Idetic/OCC_boards/README.md

# OCC_boards
Repository to share of OCC related PCB.
