Idetic/OCC_boards/Constant_Current_PCB/last_version/README.md

# STM32 Constant-Current LED Driver Board

A compact STM32-controlled LED driver with an adjustable linear current sink, high-side current sensing, USB-C, and expansion headers. The circuit can drive an external LED from a 5 V supply, with the current reference provided by the MCU's PA4 DAC output.

This document describes the checked-in KiCad schematic and PCB. Values are design values, not measured performance guarantees. Output current limits, modulation bandwidth, and thermal performance still require characterization.

## Board specifications

| Parameter | Design specification |
| --- | --- |
| Project | `hat_rpizero_tx` |
| CAD version | PCB saved with KiCad 9.0 |
| PCB outline | 39.67 × 22.70 mm, rectangular, measured from Edge.Cuts |
| Configured PCB thickness | 1.6062 mm |
| Copper layers | Four: F.Cu, In1.Cu, In2.Cu, B.Cu |
| Dielectric | FR4 in the configured stackup |
| Configured copper thickness | Outer layers: 35 µm; inner layers: 15.2 µm |
| Supply rail | Nominal +5 V from USB-C or POWER2 |
| Logic rail | +3.3 V, generated by U4 (TLV75533PDBVR) |
| Microcontroller | U1: STM32L432KCU6, UFQFPN-32 with exposed pad |
| External crystal | X1: 32.768 kHz, specified component load capacitance 6 pF and tolerance 20 ppm |
| Crystal capacitors | C1, C2: 8 pF each |
| LED outputs | One external LED connection, LED1 |
| Current control | U2 MCP6001T-I/OT, Q1 2N2222AU, R5 and R7 trimmers |
| Current measurement | U3 INA199A1DCKR with R8 = 0.110 Ω high-side shunt |
| Interfaces | USB data, SWD, serial signal header, I²C, PA1–PA3, two DAC signals |
| Firmware | No firmware or flashing image included in this directory |

The project filename does not establish Raspberry Pi HAT compatibility. The current PCB has no 40-pin Raspberry Pi header.

## Power

USB1 VBUS and POWER2 pin 1 connect directly to the same +5 V net. U4 generates +3.3 V for the MCU and logic headers; U2 and U3 use +5 V. USB-C CC1 and CC2 each have a 5.1 kΩ pull-down resistor (R9 and R10).

The design has no separate power-source selection or isolation between USB VBUS and POWER2. Use one supply source at a time unless the external power arrangement explicitly handles the shared rail. The files do not establish an approved input-voltage range or total current budget.

## LED current driver

The LED current path is:

```text
+5 V → R8 (0.110 Ω) → LED1 pin 1 → external LED
     → LED1 pin 2 → Q1 collector/emitter → R7 → GND
```

U2 compares the R5 wiper voltage with Q1's emitter voltage and drives Q1's base. R5 is a 10 kΩ trimmer between DAC1/PA4 and ground. R7 is a 100 Ω trimmer used as a variable emitter resistor; its third terminal is unconnected. R6 is a 10 kΩ resistor between Q1 base and emitter.

While the feedback loop is regulating, the approximate relationships are:

```text
V_reference = α × V_DAC1                  (0 ≤ α ≤ 1, set by R5)
I_emitter ≈ V_reference / R7_effective
I_LED ≈ I_emitter                        (neglecting base current and R6 current)
V_shunt = I_LED × 0.110 Ω
V_I_LED ≈ G_INA199A1 × V_shunt            (within the amplifier's operating limits)
```

These equations describe circuit operation, not a safe current range. R7 can approach zero resistance, so its marked 100 Ω value does not provide a fixed minimum current-limiting resistance. The usable current depends on trimmer settings, DAC voltage, LED forward voltage, transistor dissipation, component ratings, and available voltage headroom. The board does not include a switching boost stage.

U3 measures the voltage across R8. Its output is available at SW2 pin 4 (`I_LED`); the netlist does not connect this output directly to an MCU ADC input. Check the amplifier output range before connecting it to a 3.3 V input.

## Connector pinouts

Pin numbers below follow the schematic symbols and PCB pad numbers. Use the footprint's pin-1 marker to determine physical orientation.

| Connector | Pin | Signal | Description |
| --- | --- | --- | --- |
| POWER2 | 1 | +5V | Supply input, shared with USB VBUS |
| POWER2 | 2 | GND | Supply return |
| LED1 | 1 | LED+ | LED anode supply, after R8 |
| LED1 | 2 | LED− / Collector | LED cathode connection to Q1 collector; not ground |
| DAC1 | 1 | DAC1 | MCU PA4; also feeds R5 |
| DAC1 | 2 | DAC2 | MCU PA5; this connector has no ground pin |
| I2C1 | 1 | +3.3V | Logic supply |
| I2C1 | 2 | GND | Ground |
| I2C1 | 3 | SDA | MCU PB7, 4.7 kΩ pull-up to +3.3 V |
| I2C1 | 4 | SCL | MCU PB6, 4.7 kΩ pull-up to +3.3 V |
| USART1 | 1 | +3.3V | Logic supply |
| USART1 | 2 | GND | Ground |
| USART1 | 3 | USART1_TX | MCU PA9 through R13 (100 Ω) |
| USART1 | 4 | USART1_RX | MCU PA8 through R14 (100 Ω); see review notes |
| SW2 | 1 | SWCLK | MCU PA14 through R3 (75 Ω) |
| SW2 | 2 | SWDIO | MCU PA13 through R4 (75 Ω) |
| SW2 | 3 | NRST | Isolated net in the current design; see review notes |
| SW2 | 4 | I_LED | U3 current-sense output |
| PA1 | 1 | +3.3V | Logic supply |
| PA1 | 2 | GND | Ground |
| PA1 | 3 | PA1 input | MCU PA1 through R15 (1 kΩ); C13 (100 nF) to ground at MCU side |
| PA2 | 1 | +3.3V | Logic supply |
| PA2 | 2 | GND | Ground |
| PA2 | 3 | PA2 | MCU PA2, 10 kΩ pull-up to +3.3 V |
| PA3 | 1 | +3.3V | Logic supply |
| PA3 | 2 | GND | Ground |
| PA3 | 3 | PA3 | MCU PA3, 10 kΩ pull-down to ground |

The pin headers use 2.54 mm pitch. POWER2 and LED1 use two-position terminal-block footprints with 2.54 mm pitch.

USB1 routes D− to MCU PA11 and D+ to PA12. USB functionality depends on firmware. The serial header exposes logic signals; no RS-232 or RS-485 transceiver is present.

## Boot, reset, and programming

- SW1 selects the BOOT0 connection between +3.3 V and ground through R18 (10 kΩ). R1 adds a permanent 10 kΩ pull-down on BOOT0.
- SW3 pulls the MCU NRST pin to ground. R2 (10 kΩ) pulls that pin up to +3.3 V, and C9 (100 nF) connects it to ground.
- SW2 provides SWCLK and SWDIO through 75 Ω series resistors. It provides neither a ground pin nor a +3.3 V reference pin; obtain those from another header when connecting a debugger.
- Firmware must configure the DAC and peripherals before their intended behavior can be specified. No default LED current, USB protocol, serial baud rate, or modulation waveform is defined by these hardware files.

## Design review notes

The following observations are present in both the exported schematic netlist and PCB pad-net assignments:

| Item | Observation and implication |
| --- | --- |
| SW2 reset | SW2 pin 3 is on `/NRST`, while MCU pin 4, SW3, R2, and C9 are on `Net-(U1-NRST)`. SW2 pin 3 therefore does not provide MCU reset in the current design. |
| Serial RX | The `USART1_RX` net connects to PA8, and PA10 is unconnected. Verify the MCU alternate-function mapping and intended firmware before relying on this as a hardware USART receive interface. |
| MCU exposed pad | U1 pad 33 is assigned an unconnected net. Confirm the package's exposed-pad connection requirements before fabrication. |
| Current readback | `I_LED` is exposed on SW2 pin 4 without a direct MCU ADC connection. |

These are connectivity observations, not a complete electrical-rule, routing, or manufacturability review.

## Initial setup and characterization

1. Review the connector orientation, LED polarity, and design notes above.
2. With power disconnected, set R5 toward its ground end and set R7 to a high effective resistance. Verify the settings with a meter.
3. Connect the external LED to LED1 and apply a current-limited nominal 5 V supply through one power input.
4. Verify +5 V and +3.3 V, then program the MCU using SWD with a shared ground and suitable voltage reference from another header.
5. Start with a low DAC1 reference. Measure LED current externally while adjusting the reference and trimmers; monitor transistor and trimmer temperature.
6. Record the usable current range, thermal limits, and current-sense calibration before operating at the intended load or modulation rate.

## Project files and manufacturing

| Path | Contents |
| --- | --- |
| [hat_rpizero_tx.kicad_pro](hat_rpizero_tx.kicad_pro) | KiCad project settings |
| [hat_rpizero_tx.kicad_sch](hat_rpizero_tx.kicad_sch) | Top-level schematic, power and connectors |
| [STM32.kicad_sch](STM32.kicad_sch) | MCU, crystal, boot and reset circuitry |
| [Driver_LED.kicad_sch](Driver_LED.kicad_sch) | LED current driver and sensing circuitry |
| [hat_rpizero_tx.kicad_pcb](hat_rpizero_tx.kicad_pcb) | PCB layout and stackup |
| `sym-lib-table`, `fp-lib-table` | Symbol and footprint library configuration |
| `models/`, `models.pretty/`, `models.3dshapes/` | Local component resources |
| [jlcpcb/](jlcpcb/) | Fabrication and assembly exports |
| [jlcpcb/production_files/BOM-hat_rpizero_tx.csv](jlcpcb/production_files/BOM-hat_rpizero_tx.csv) | BOM with values, designators, footprints and LCSC codes |
| [jlcpcb/production_files/CPL-hat_rpizero_tx.csv](jlcpcb/production_files/CPL-hat_rpizero_tx.csv) | Component placement export |
| `jlcpcb_old/`, `jlcpcb_viaje_turin_03-03-26/` | Earlier manufacturing export sets |
| `hat_rpizero_tx-backups/` | KiCad project backups |

Open the `.kicad_pro` file in KiCad 9 or a compatible later version. Resolve any library paths needed on the local machine. Regenerate fabrication and assembly exports from the reviewed PCB before ordering: existing exports are snapshots and are not established here as matching the latest layout. The configured stackup is a CAD setting; confirm the actual fabrication stackup with the manufacturer.

## Specifications still to establish

| Specification | Status |
| --- | --- |
| Approved input-voltage range and maximum supply current | Not characterized |
| Minimum and maximum regulated LED current | Not characterized |
| Supported LED forward-voltage range | Not characterized |
| Current accuracy, ripple and calibration | Not characterized |
| Continuous power and thermal limits | Not characterized |
| Modulation bandwidth and optical data rate | Not characterized |
| Operating and storage temperature ranges | Not established |
| Firmware repository, build and flashing instructions | Not supplied |
| Hardware revision and matching manufacturing release | Not identified |
| License | No license file supplied |
