Idetic/OCC_boards/Constant_Current_PCB/last_version/jlcpcb/production_files/BOM-hat_rpizero_tx.csv

Comment | Designator | Footprint | LCSC | Quantity
0.1uF | C10 | C_0402_1005Metric | C307331 | 1
100 | R13,R14 | R_0402_1005Metric | C25076 | 2
100n | C13 | C_0402_1005Metric | C307331 | 1
100nF | C3,C4,C7,C9 | C0402 | C307331 | 4
10k | R1,R16,R17,R18,R2,R6 | R0402 | C25744 | 6
10uF | C5,C6 | C0402 | C15525 | 2
110m | R8 | R1206 | C2934288 | 1
1k | R15 | R_0402_1005Metric | C11702 | 1
1u | C11,C12 | C_0603_1608Metric | C15849 | 2
1uF | C8 | C0402 | C52923 | 1
2N2222AU | Q1 | SOT-89-3_L4.5-W2.4-P1.50-LS4.0-BR | C21714170 | 1
3296W-1-101_C48997939 | R7 | RES-ADJ-TH_3296W | C48997939 | 1
3296W-1-103_C48997937 | R5 | RES-ADJ-TH_3296W | C48997937 | 1
4.7k | R11,R12 | R_0402_1005Metric | C25900 | 2
5.1k | R10,R9 | R_0402_1005Metric | C25905 | 2
75 | R3,R4 | R_0402_1005Metric | C413061 | 2
8pF | C1,C2 | C_0402_1005Metric | C161336 | 2
Conn_01x02 | DAC1 | PinHeader_1x02_P2.54mm_Vertical | C124375 | 1
Conn_01x02 | LED1,POWER2 | CONN-TH_DB125-2.54-2P-GN | C918120 | 2
Conn_01x03 | PA1,PA2,PA3 | PinHeader_1x03_P2.54mm_Vertical | C49257 | 3
Conn_01x04 | I2C1,SW2,USART1 | PinHeader_1x04_P2.54mm_Vertical | C124378 | 3
GT-USB-7010C | USB1 | USB-C-SMD_GT-USB-7010C | C2843967 | 1
INA199A1DCKR | U3 | SC-70-6_L2.2-W1.3-P0.65-LS2.1-BR | C59135 | 1
MC-306 32.768kHz 6.0pF 20ppm | X1 | MC-306_4P-L8.0-W3.2-P5.5-BL | C83979 | 1
MCP6001T-I/OT | U2 | SOT-23-5_L3.0-W1.7-P0.95-LS2.8-BR | C116490 | 1
MK-11C04-G013 | SW1 | SW-SMD_MK-11C04-G013 | C778185 | 1
STM32L432KCU6 | U1 | UFQFPN-32_L5.0-W5.0-P0.50-TL-EP3.5 | C1337280 | 1
TLV75533PDBVR | U4 | SOT-23-5_L3.0-W1.7-P0.95-LS2.8-BR | C404027 | 1
TS-1088-AR02016 | SW3 | SW-SMD_L3.9-W3.0-P4.45 | C720477 | 1
