Idetic/OCC_boards/Constant_Current_PCB/circuit/3dModels/Screw Terminal Block 5mm 3-way.step

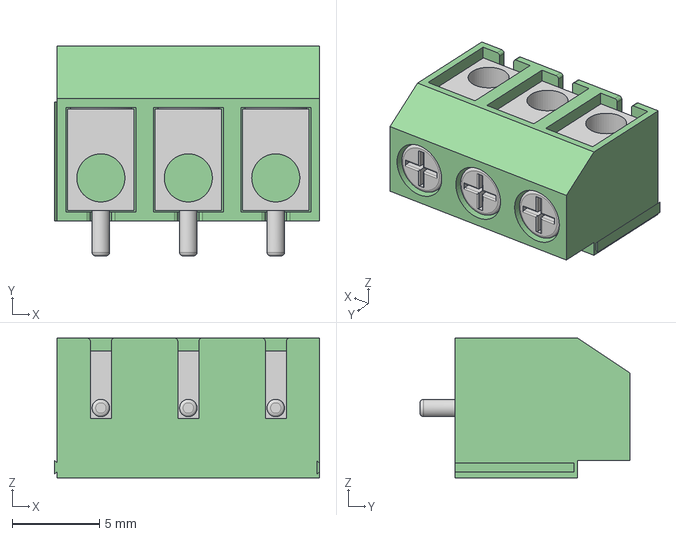
[picture p3: CAD file, 2024-10-03]
Constant_Current_PCB/circuit/3dModels/Screw Terminal Block 5mm 3-way.step
15.2 x 12.0 x 8.00 mm
