Idetic/OCC_boards/Constant_Current_PCB/circuit/3dModels/Screw Terminal Block 5mm 2-way.step

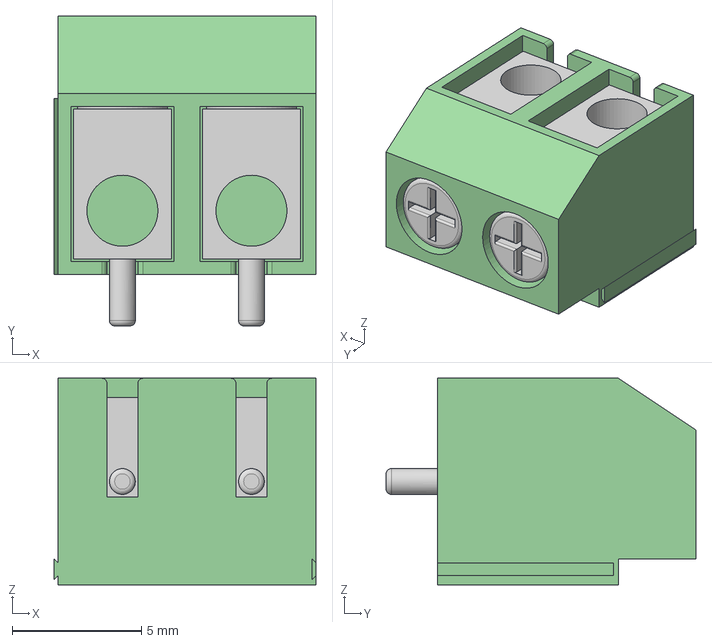
[picture p4: CAD file, 2024-10-03]
Constant_Current_PCB/circuit/3dModels/Screw Terminal Block 5mm 2-way.step
10.2 x 12.0 x 8.00 mm
