Idetic/OCC_boards/Constant_Current_PCB/last_version/hat_rpizero_tx.kicad_pcb

## KiCad design Constant_Current_PCB/last_version/hat_rpizero_tx.kicad_pcb (2026-10-20)

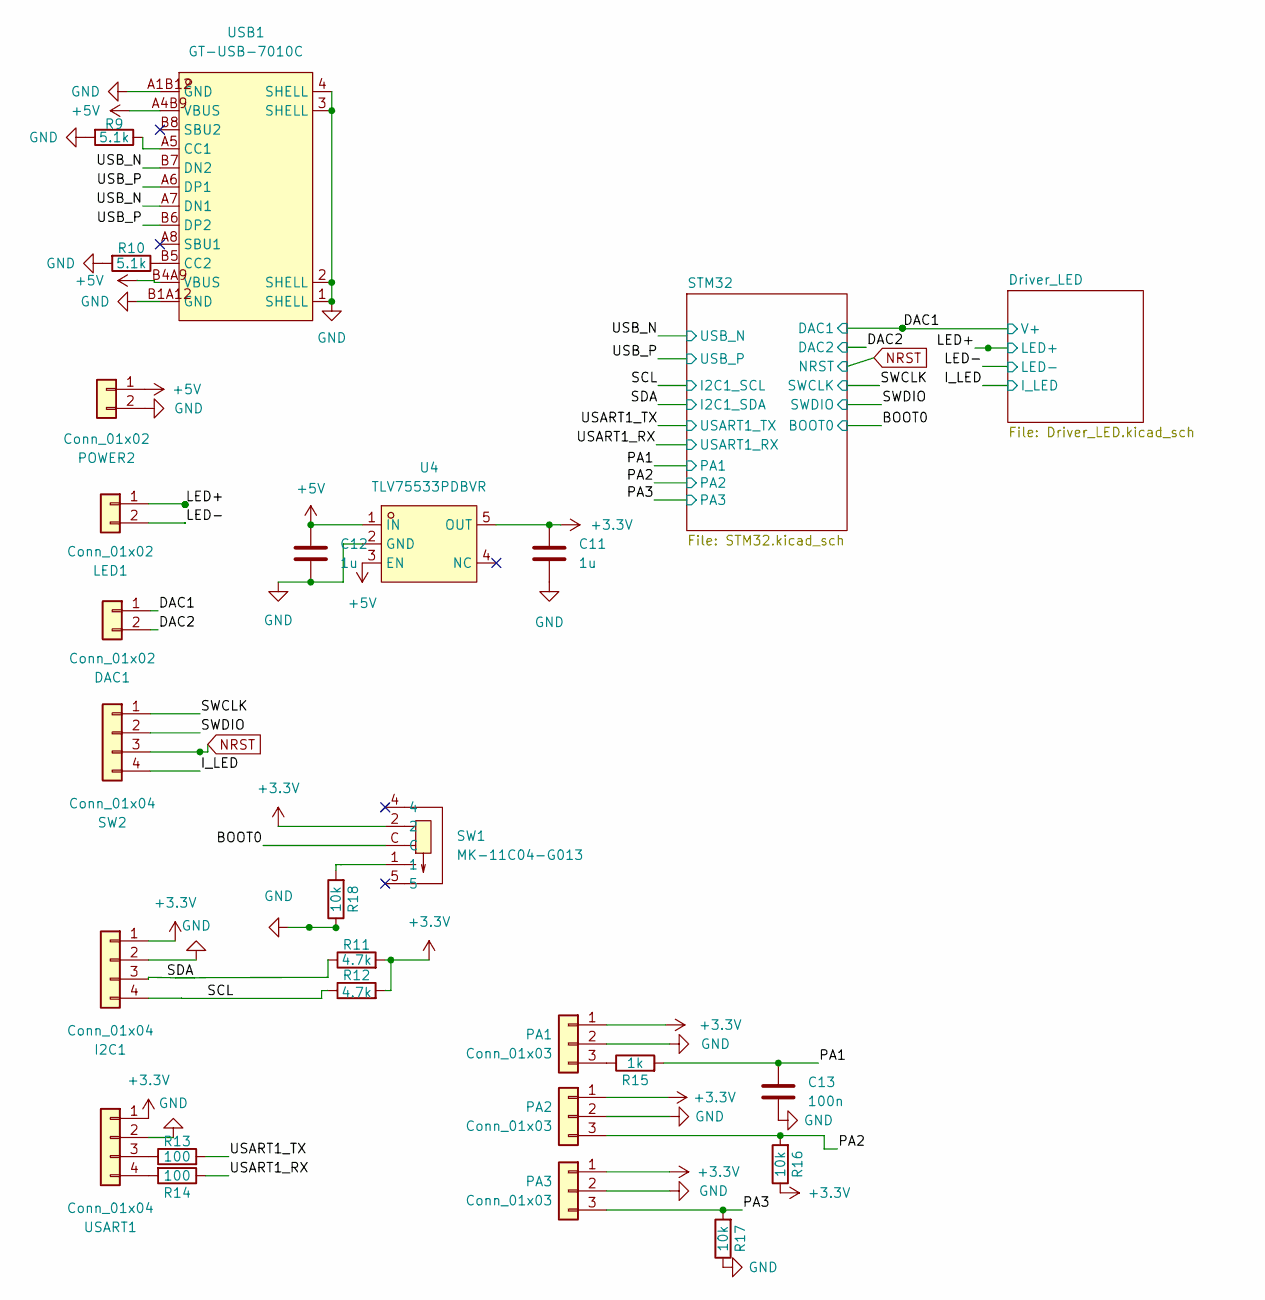
[picture p5: schematic hat_rpizero_tx.kicad_sch]

Parts:
C11, C12: 1u; C_0603_1608Metric; LCSC C15849
C13: 100n; C_0402_1005Metric; LCSC Part C307331
DAC1: Conn_01x02; PinHeader_1x02_P2.54mm_Vertical; LCSC C124375
I2C1: Conn_01x04; PinHeader_1x04_P2.54mm_Vertical; LCSC C124378
LED1: Conn_01x02; CONN-TH_DB125-2.54-2P-GN; LCSC C918120
PA1, PA2, PA3: Conn_01x03; PinHeader_1x03_P2.54mm_Vertical; LCSC C49257
POWER2: Conn_01x02; CONN-TH_DB125-2.54-2P-GN; LCSC C918120
R9, R10: 5.1k; R_0402_1005Metric; LCSC Part C25905
R11, R12: 4.7k; R_0402_1005Metric; LCSC Part C25900
R13, R14: 100; R_0402_1005Metric; LCSC Part C25076
R15: 1k; R_0402_1005Metric; LCSC Part C11702
R16, R17, R18: 10k; R_0402_1005Metric; LCSC Part C25744
SW1: MK-11C04-G013; SW-SMD_MK-11C04-G013; LCSC Part C778185
SW2: Conn_01x04; PinHeader_1x04_P2.54mm_Vertical; LCSC C124378
U4: TLV75533PDBVR; SOT-23-5_L3.0-W1.7-P0.95-LS2.8-BR; LCSC Part C404027
USART1: Conn_01x04; PinHeader_1x04_P2.54mm_Vertical; LCSC C124378
USB1: GT-USB-7010C; USB-C-SMD_GT-USB-7010C; MPN GT-USB-7010C; LCSC Part C2843967

Connections:
+3.3V: C11.1, I2C1.1, PA1.1, PA2.1, PA3.1, R11.2, R12.2, R16.1, SW1.2, U4.5 (OUT), USART1.1; also elsewhere on the board
+5V: C12.1, POWER2.1, U4.1 (IN), U4.3 (EN), USB1.A4B9 (VBUS), USB1.B4A9 (VBUS); also elsewhere on the board
/BOOT0: SW1.C; also elsewhere on the board
/DAC1: DAC1.1; also elsewhere on the board
/DAC2: DAC1.2; also elsewhere on the board
/I_LED: SW2.4; also elsewhere on the board
/LED+: LED1.1; also elsewhere on the board
/PA1: C13.1, R15.2; also elsewhere on the board
/PA2: PA2.3, R16.2; also elsewhere on the board
/PA3: PA3.3, R17.2; also elsewhere on the board
/SCL: I2C1.4, R12.1; also elsewhere on the board
/SDA: I2C1.3, R11.1; also elsewhere on the board
/SWCLK: SW2.1; also elsewhere on the board
/SWDIO: SW2.2; also elsewhere on the board
/USART1_RX: R14.1; also elsewhere on the board
/USART1_TX: R13.2; also elsewhere on the board
/USB_N: USB1.A7 (DN1), USB1.B7 (DN2); also elsewhere on the board
/USB_P: USB1.A6 (DP1), USB1.B6 (DP2); also elsewhere on the board
Collector: LED1.2; also elsewhere on the board
GND: C11.2, C12.2, C13.2, I2C1.2, PA1.2, PA2.2, PA3.2, POWER2.2, R9.2, R10.2, R17.1, R18.1, U4.2 (GND), USART1.2, USB1.1 (SHELL), USB1.2 (SHELL), USB1.3 (SHELL), USB1.4 (SHELL), USB1.A1B12 (GND), USB1.B1A12 (GND); also elsewhere on the board
NRST: SW2.3; also elsewhere on the board
unnamed: PA1.3, R15.1
unnamed: R18.2, SW1.1
unnamed: R13.1, USART1.3
unnamed: R14.2, USART1.4
unnamed: R9.1, USB1.A5 (CC1)
unnamed: R10.1, USB1.B5 (CC2)

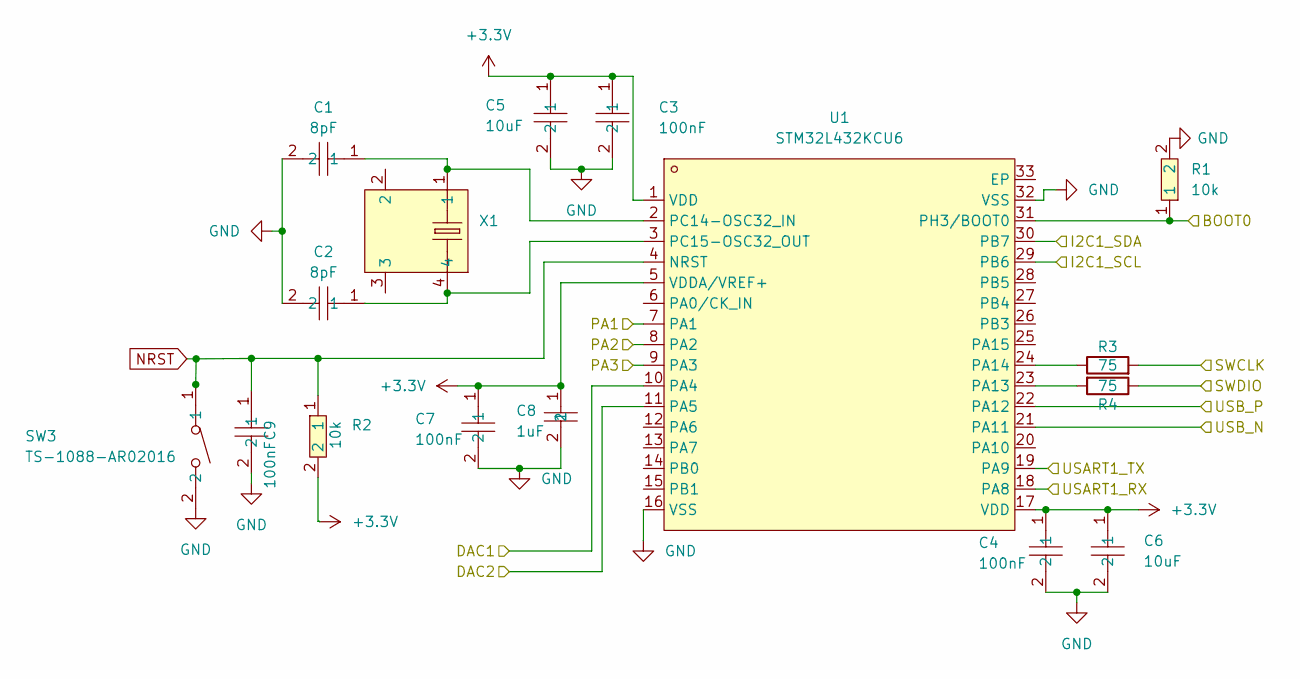
[picture p6: schematic STM32.kicad_sch]

Parts:
C1, C2: 8pF; C_0402_1005Metric; LCSC Part C161336
C3, C4, C7, C9: 100nF; C0402; LCSC Part C307331
C5, C6: 10uF; C0402; LCSC Part C15525
C8: 1uF; C0402; LCSC Part C52923
R1, R2: 10k; R0402; LCSC Part C25744
R3, R4: 75; R_0402_1005Metric; LCSC C4275
SW3: TS-1088-AR02016; SW-SMD_L3.9-W3.0-P4.45; LCSC Part C720477
U1: STM32L432KCU6; UFQFPN-32_L5.0-W5.0-P0.50-TL-EP3.5; LCSC Part C1337280
X1: MC-306 32.768kHz 6.0pF 20ppm; MC-306_4P-L8.0-W3.2-P5.5-BL; LCSC Part C83979

Connections:
+3.3V: C3.1, C4.1, C5.1, C6.1, C7.1, C8.1, R2.2, U1.1 (VDD), U1.5 (VDDA/VREF+), U1.17 (VDD); also elsewhere on the board
/BOOT0: R1.1, U1.31 (PH3/BOOT0); also elsewhere on the board
/DAC1: U1.10 (PA4); also elsewhere on the board
/DAC2: U1.11 (PA5); also elsewhere on the board
/PA1: U1.7 (PA1); also elsewhere on the board
/PA2: U1.8 (PA2); also elsewhere on the board
/PA3: U1.9 (PA3); also elsewhere on the board
/SCL: U1.29 (PB6); also elsewhere on the board
/SDA: U1.30 (PB7); also elsewhere on the board
/SWCLK: R3.2; also elsewhere on the board
/SWDIO: R4.1; also elsewhere on the board
/USART1_RX: U1.18 (PA8); also elsewhere on the board
/USART1_TX: U1.19 (PA9); also elsewhere on the board
/USB_N: U1.21 (PA11); also elsewhere on the board
/USB_P: U1.22 (PA12); also elsewhere on the board
GND: C1.2, C2.2, C3.2, C4.2, C5.2, C6.2, C7.2, C8.2, C9.2, R1.2, SW3.2, U1.16 (VSS), U1.32 (VSS); also elsewhere on the board
NRST: C9.1, R2.1, SW3.1, U1.4 (NRST); also elsewhere on the board
unnamed: R4.2, U1.23 (PA13)
unnamed: R3.1, U1.24 (PA14)
unnamed: C1.1, U1.2 (PC14-OSC32_IN), X1.1
unnamed: C2.1, U1.3 (PC15-OSC32_OUT), X1.4

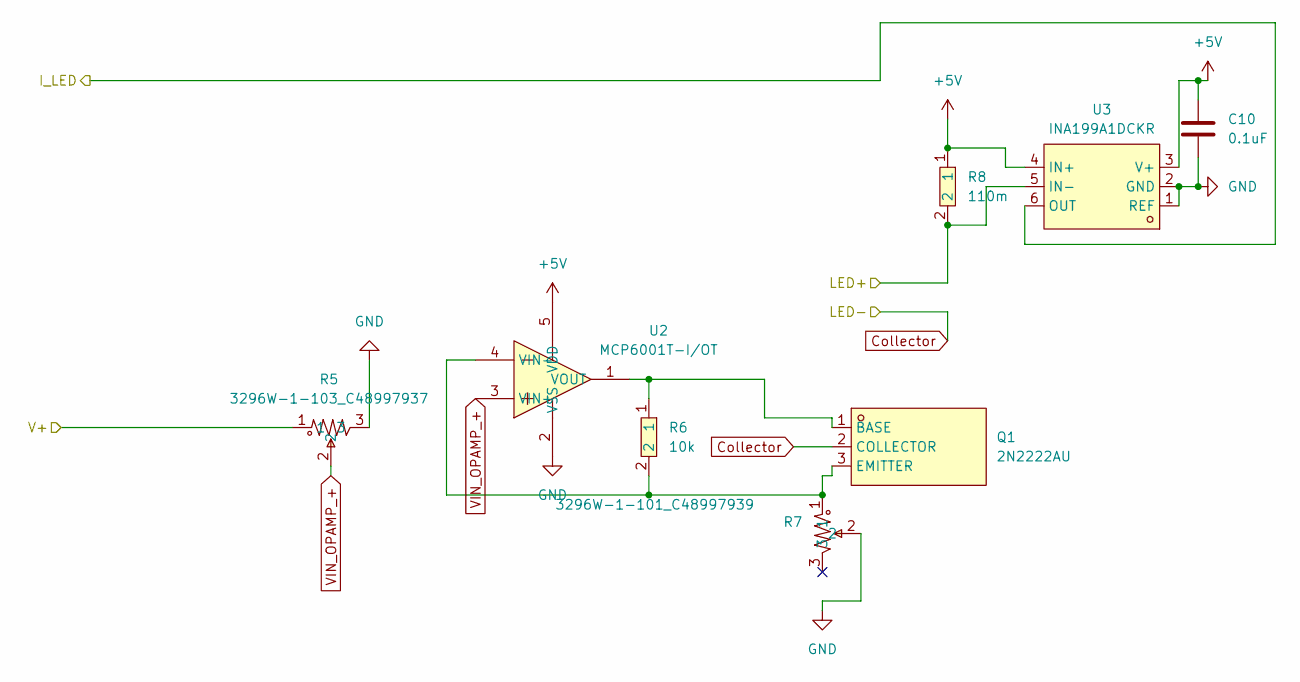
[picture p7: schematic Driver_LED.kicad_sch]

Parts:
C10: 0.1uF; C_0402_1005Metric; LCSC C307331
Q1: 2N2222AU; SOT-89-3_L4.5-W2.4-P1.50-LS4.0-BR; LCSC Part C21714170
R5: 3296W-1-103_C48997937; RES-ADJ-TH_3296W; LCSC Part C48997937
R6: 10k; R_0402_1005Metric; LCSC Part C25744
R7: 3296W-1-101_C48997939; RES-ADJ-TH_3296W; LCSC Part C48997939
R8: 110m; R1206; LCSC Part C2934288
U2: MCP6001T-I/OT; SOT-23-5_L3.0-W1.7-P0.95-LS2.8-BR; LCSC Part C116490
U3: INA199A1DCKR; SC-70-6_L2.2-W1.3-P0.65-LS2.1-BR; LCSC Part C59135

Connections:
+5V: C10.1, R8.1, U2.5 (VDD), U3.3 (V+), U3.4 (IN+); also elsewhere on the board
/DAC1: R5.1; also elsewhere on the board
/I_LED: U3.6 (OUT); also elsewhere on the board
/LED+: R8.2, U3.5 (IN-); also elsewhere on the board
Collector: Q1.2 (COLLECTOR); also elsewhere on the board
GND: C10.2, R5.3, R7.2, U2.2 (VSS), U3.1 (REF), U3.2 (GND); also elsewhere on the board
unnamed: Q1.1 (BASE), R6.1, U2.1 (VOUT)
unnamed: Q1.3 (EMITTER), R6.2, R7.1, U2.4 (VIN-)
VIN_OPAMP_+: R5.2, U2.3 (VIN+)

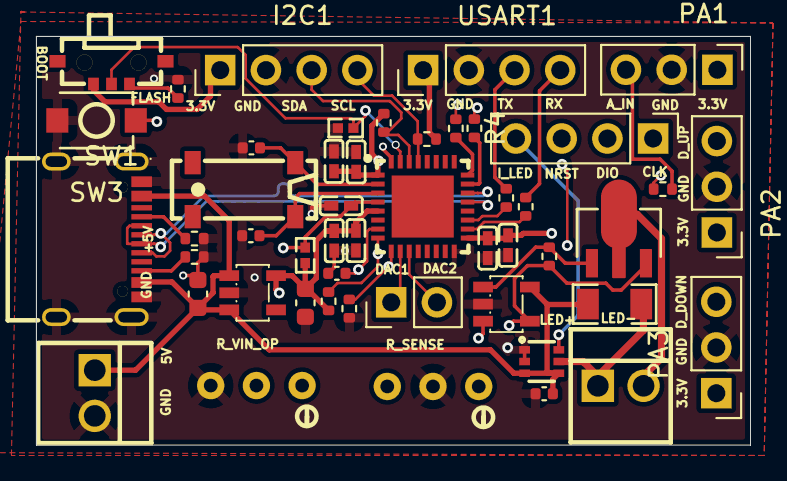
[picture p8: board hat_rpizero_tx.kicad_pcb from above]

Board: 4 copper layers, 39.7 x 22.7 mm, 49 parts (0 on the bottom side), 34 nets.
