Idetic/OCC_boards/Constant_Current_PCB/circuit/signal_conditioning.kicad_pcb

## KiCad design Constant_Current_PCB/circuit/signal_conditioning.kicad_pcb (2024-10-03)

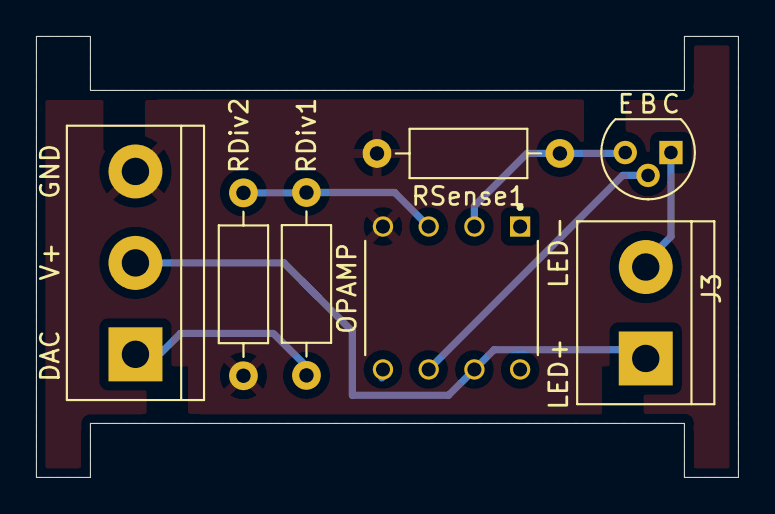
[picture p9: board signal_conditioning.kicad_pcb from above]

Board: 2 copper layers, 39.0 x 24.5 mm, 7 parts (0 on the bottom side), 7 nets.

Parts:
J2: Screw_Terminal_01x03; TerminalBlock_bornier-3_P5.08mm
J3: Screw_Terminal_01x02; TerminalBlock_bornier-2_P5.08mm
OPAMP: TL081CP; DIP794W45P254L959H508Q8
Q1: NPN; TO-92
RDiv1, RDiv2: R; R_Axial_DIN0207_L6.3mm_D2.5mm_P10.16mm_Horizontal
RSense1: R; R_Axial_DIN0207_L6.3mm_D2.5mm_P10.16mm_Horizontal

Connections:
GND: J2.3, OPAMP.4 (VCC-), RDiv2.1, RSense1.2
LED+: J2.2, J3.1, OPAMP.7 (VCC+)
LED-: J3.2, Q1.1 (C)
unnamed: J2.1, RDiv1.1
unnamed: OPAMP.6 (OUT), Q1.2 (B)
unnamed: OPAMP.2 (IN-), Q1.3 (E), RSense1.1
unnamed: OPAMP.3 (IN_+), RDiv1.2, RDiv2.2
