Idetic/OCC_boards/(commit log)

2024-09-20 Constan Current PCB
    [signal_conditioning.kicad_pcb, signal_conditioning.kicad_sch]
2024-10-02 1 version done
    [signal_conditioning.kicad_pcb, signal_conditioning.kicad_sch]
2024-10-03 add 3d view - fix img
    [Screw Terminal Block 5mm 2-way.step, Screw Terminal Block 5mm 3-way.step, signal_conditioning.kicad_pcb]
2024-10-03 component list
    [signal_conditioning.kicad_sch]
2026-10-20 last version board
